daharoni/Miniscope_DAQ_PCB/v3_2/Assembly Files/USB_Control_FPD_Linkv2_BOM.xlsx

Value | Comment | Digikey Part Number | Manufacturer Part Number | Designator | Footprint | LibRef | Quantity
CAPACITORS
N/A | Open Capacitor | N/A | N/A | C73 | 0603 |  | 1 | 178
0.01uF | CAP CER 10000PF 50V 10% X7R 0603 | 490-1512-1-ND (http://www.digikey.com/product-detail/en/GRM188R71H103KA01D/490-1512-1-ND/587862) | GRM188R71H103KA01D (http://www.digikey.com/product-detail/en/GRM188R71H103KA01D/490-1512-1-ND/587862) | C6, C8, C11, C14, C16, C19, C25, C28, C29, C31, C38, C43, C44, C47, C49, C51, C60, C62, C64, C66, C82 | 0603 |  | 21
0.047uF | CAP CER 0.047UF 25V 10% X7R 0402 | 490-3254-1-ND (http://www.digikey.com/product-detail/en/GRM155R71E473KA88D/490-3254-1-ND/702795) | GRM155R71E473KA88D (http://www.digikey.com/product-detail/en/GRM155R71E473KA88D/490-3254-1-ND/702795) | C22, C27 | 0402 |  | 2
0.1uF | CAP CER 0.1UF 16V 10% X7R 0402 | 490-3261-1-ND (http://www.digikey.com/product-detail/en/GRM155R71C104KA88D/490-3261-1-ND/702802) | GRM155R71C104KA88D (http://www.digikey.com/product-detail/en/GRM155R71C104KA88D/490-3261-2-ND/675947) | C21, C26, C77 | 0402 |  | 3
0.1uF | CAP CER 0.1UF 16V 10% X7R 0603 | 490-1532-1-ND (http://www.digikey.com/product-detail/en/GRM188R71C104KA01D/490-1532-1-ND/587771) | GRM188R71C104KA01D (http://www.digikey.com/product-detail/en/GRM188R71C104KA01D/490-1532-1-ND/587771) | C1, C2, C3, C7, C9, C12, C15, C17, C20, C24, C32, C37, C40, C41, C42, C45, C46, C48, C50, C52, C54, C56, C58, C59, C61, C63, C65, C69, C78, C79 | 0603 |  | 30
1uF | CAP CER 1UF 10V 10% X5R 0603 | 490-1543-1-ND (http://www.digikey.com/product-detail/en/GRM188R61A105KA61D/490-1543-1-ND/587782) | GRM188R61A105KA61D (http://www.digikey.com/product-detail/en/GRM188R61A105KA61D/490-1543-1-ND/587782) | C4, C5, C70 | 0603 |  | 3
2.2uF | CAP CER 2.2UF 16V 10% X5R 0603 | 490-3296-1-ND (http://www.digikey.com/product-detail/en/GRM188R61C225KE15D/490-3296-1-ND/702837) | GRM188R61C225KE15D (http://www.digikey.com/product-detail/en/GRM188R61C225KE15D/490-3296-1-ND/702837) | C53, C74 | 0603 |  | 2
4.7uF | CAP CER 4.7UF 16V 10% X5R 0603 | 490-10730-1-ND (http://www.digikey.com/product-detail/en/GRM188R61C475KE11D/490-10730-1-ND/5251370) | GRM188R61C475KE11D (http://www.digikey.com/product-detail/en/GRM188R61C475KE11D/490-10730-1-ND/5251370) | C10, C23, C67, C68, C75, C76 | 0603 |  | 6
10uF | CAP CER 10UF 16V 20% X5R 0603 | 490-7201-1-ND (http://www.digikey.com/product-detail/en/GRM188R61C106MA73D/490-7201-1-ND/3900482) | GRM188R61C106MA73D (http://www.digikey.com/product-detail/en/GRM188R61C106MA73D/490-7201-1-ND/3900482) | C30, C71, C72 | 0603 |  | 3
22uF | CAP CER 22UF 6.3V 20% X5R 0603 | 490-7611-1-ND (http://www.digikey.com/product-detail/en/GRM188R60J226MEA0D/490-7611-1-ND/4280544) | GRM188R60J226MEA0D (http://www.digikey.com/product-detail/en/GRM188R60J226MEA0D/490-7611-1-ND/4280544) | C13, C18, C39, C55, C57 | 0603 |  | 5
100uF | CAP TANT 100UF 6.3V 20% 1206 | 511-1498-1-ND (http://www.digikey.com/product-detail/en/TCTAL0J107M8R/511-1498-1-ND/1209675) | TCTAL0J107M8R (http://www.digikey.com/product-detail/en/TCTAL0J107M8R/511-1498-1-ND/1209675) | C33, C34 | 1206 |  | 2
330uF | CAP TANT 330UF 10V 10% 2917 | 399-3884-1-ND (http://www.digikey.com/product-detail/en/T495D337K010ATE125/399-3884-1-ND/819209) | T495D337K010ATE125 (http://www.digikey.com/product-detail/en/T495D337K010ATE125/399-3884-1-ND/819209) | C35, C36 | 2917 |  | 2
RESISTORS
N/A | Open Resistor | N/A | N/A | R27, R30, R32 | 0603 |  | 3
0 | RES SMD 0.0 OHM JUMPER 1/10W | 311-0.0HRCT-ND (http://www.digikey.com/product-detail/en/RC0603FR-070RL/311-0.0HRCT-ND/4340584) | RC0603FR-070RL (http://www.digikey.com/product-detail/en/RC0603FR-070RL/311-0.0HRCT-ND/4340584) | R44, R45 | 0603 |  | 2
22 | RES SMD 22 OHM 1% 1/10W 0603 | 311-22.0HRCT-ND (http://www.digikey.com/product-detail/en/RC0603FR-0722RL/311-22.0HRCT-ND/730002) | RC0603FR-0722RL (http://www.digikey.com/product-detail/en/RC0603FR-0722RL/311-22.0HRCT-ND/730002) | R6, R7, R8, R9. R10. R11, R13, R15, R16, R17, R18, R19, R20, R21, R22, R23, R24, R25, R29 | 0603 |  | 19
33 | RES SMD 33 OHM 1% 1/10W 0603 | 311-33.0HRCT-ND (http://www.digikey.com/product-detail/en/RC0603FR-0733RL/311-33.0HRCT-ND/730105) | RC0603FR-0733RL (http://www.digikey.com/product-detail/en/RC0603FR-0733RL/311-33.0HRCT-ND/730105) | R59 | 0603 |  | 1
49.9 | RES SMD 49.9 OHM 1% 1/16W 0402 | 311-49.9LRCT-ND (http://www.digikey.com/product-detail/en/RC0402FR-0749R9L/311-49.9LRCT-ND/729568) | RC0402FR-0749R9L (http://www.digikey.com/product-detail/en/RC0402FR-0749R9L/311-49.9LRCT-ND/729568) | R34, R35 | 0402 |  | 2
100 | RES SMD 100 OHM 1% 1/10W 0603 | 311-100HRCT-ND (http://www.digikey.com/product-detail/en/RC0603FR-07100RL/311-100HRCT-ND/729835) | RC0603FR-07100RL (http://www.digikey.com/product-detail/en/RC0603FR-07100RL/311-100HRCT-ND/729835) | R64, R65, R66 | 0603 |  | 3
200 | RES SMD 200 OHM 1% 1/10W 0603 | 311-200HRCT-ND (http://www.digikey.com/product-detail/en/RC0603FR-07200RL/311-200HRCT-ND/729990) | RC0603FR-07200RL (http://www.digikey.com/product-detail/en/RC0603FR-07200RL/311-200HRCT-ND/729990) | R5 | 0603 |  | 1
430 | RES SMD 430 OHM 1% 1/10W 0603 | 311-430HRCT-ND (http://www.digikey.com/product-detail/en/RC0603FR-07430RL/311-430HRCT-ND/730183) | RC0603FR-07430RL (http://www.digikey.com/product-detail/en/RC0603FR-07430RL/311-430HRCT-ND/730183) | R52 | 0603 |  | 1
1k | RES SMD 1K OHM 1% 1/10W 0603 | 311-1.00KHRCT-ND (http://www.digikey.com/product-detail/en/RC0603FR-071KL/311-1.00KHRCT-ND/729790) | RC0603FR-071KL (http://www.digikey.com/product-detail/en/RC0603FR-071KL/311-1.00KHRCT-ND/729790) | R50, R60, R61, R63, R56, R57 | 0603 |  | 6
1.15k | RES SMD 1.15K OHM 1% 1/10W 0603 | 311-1.15KHRCT-ND (http://www.digikey.com/product-detail/en/RC0603FR-071K15L/311-1.15KHRCT-ND/729797) | RC0603FR-071K15L (http://www.digikey.com/product-detail/en/RC0603FR-071K15L/311-1.15KHRCT-ND/729797) | R55 | 0603 |  | 1
2k | RES SMD 2K OHM 1% 1/10W 0603 | 311-2.00KHRCT-ND (http://www.digikey.com/product-detail/en/RC0603FR-072KL/311-2.00KHRCT-ND/729956) | RC0603FR-072KL (http://www.digikey.com/product-detail/en/RC0603FR-072KL/311-2.00KHRCT-ND/729956) | R12, R14 | 0603 |  | 2
3.57k | RES SMD 3.57K OHM 1% 1/10W 0603 | 311-3.57KHRCT-ND (http://www.digikey.com/product-detail/en/RC0603FR-073K57L/311-3.57KHRCT-ND/730078) | RC0603FR-073K57L (http://www.digikey.com/product-detail/en/RC0603FR-073K57L/311-3.57KHRCT-ND/730078) | R53 | 0603 |  | 1
6.04k | RES SMD 6.04K OHM 1% 1/10W 0603 | 311-6.04KHRCT-ND (http://www.digikey.com/product-detail/en/RC0603FR-076K04L/311-6.04KHRCT-ND/730264) | RC0603FR-076K04L (http://www.digikey.com/product-detail/en/RC0603FR-076K04L/311-6.04KHRCT-ND/730264) | R4 | 0603 |  | 1
10k | RES SMD 10K OHM 1% 1/10W 0603 | 311-10.0KHRCT-ND (http://www.digikey.com/product-detail/en/RC0603FR-0710KL/311-10.0KHRCT-ND/729827) | RC0603FR-0710KL (http://www.digikey.com/product-detail/en/RC0603FR-0710KL/311-10.0KHRCT-ND/729827) | R1, R2, R3, R26, R28, R31, R36, R37, R38, R39, R40, R41, R42, R43, R47, R48, R49, R51 | 0603 |  | 18
11K | RES SMD 11K OHM 1% 1/10W 0603 | 311-11.0KHRCT-ND (http://www.digikey.com/product-detail/en/RC0603FR-0711KL/311-11.0KHRCT-ND/729844) | RC0603FR-0711KL (http://www.digikey.com/product-detail/en/RC0603FR-0711KL/311-11.0KHRCT-ND/729844) | R46 | 0603 |  | 1
30.1k | RES SMD 30.1K OHM 1% 1/10W 0603 | 311-30.1KHRCT-ND (http://www.digikey.com/product-detail/en/RC0603FR-0730K1L/311-30.1KHRCT-ND/730089) | RC0603FR-0730K1L (http://www.digikey.com/product-detail/en/RC0603FR-0730K1L/311-30.1KHRCT-ND/730089) | R54 | 0603 |  | 1
100k | RES SMD 100K OHM 1% 1/10W 0603 | 311-100KHRCT-ND (http://www.digikey.com/product-detail/en/RC0603FR-07100KL/311-100KHRCT-ND/729836) | RC0603FR-07100KL (http://www.digikey.com/product-detail/en/RC0603FR-07100KL/311-100KHRCT-ND/729836) | R58 | 0603 |  | 1
1M | RES SMD 1M OHM 1% 1/10W 0603 | 311-1.00MHRCT-ND (http://www.digikey.com/product-detail/en/RC0603FR-071ML/311-1.00MHRCT-ND/729791) | RC0603FR-071ML (http://www.digikey.com/product-detail/en/RC0603FR-071ML/311-1.00MHRCT-ND/729791) | R33 | 0603 |  | 1
Ferrite
Ferrite | FERRITE CHIP 220 OHM 0805 | 490-1054-1-ND (http://www.digikey.com/product-detail/en/BLM21PG221SN1D/490-1054-1-ND/574418) | BLM21PG221SN1D (http://www.digikey.com/product-detail/en/BLM21PG221SN1D/490-1054-1-ND/574418) | L1, L2 | 0805 |  | 2
Ferrite | FERRITE CHIP 600 OHM 1300MA 0603 | 490-5258-1-ND (http://www.digikey.com/product-detail/en/BLM18KG601SN1D/490-5258-1-ND/1982781) | BLM18KG601SN1D (http://www.digikey.com/product-detail/en/BLM18KG601SN1D/490-5258-1-ND/1982781) | L3, L4, L11 | 0603 |  | 3
Ferrite | FIXED IND 2.2UH 600MA 340 MOHM | 490-4994-1-ND (http://www.digikey.com/product-detail/en/LQM21PN2R2MC0D/490-4994-1-ND/1788292) | LQM21PN2R2MC0D (http://www.digikey.com/product-detail/en/LQM21PN2R2MC0D/490-4994-1-ND/1788292) | L5 | 0805 |  | 1
Ferrite | FERRITE CHIP BEAD 600 OHM SMD | 445-2206-1-ND (http://www.digikey.com/product-detail/en/MPZ2012S601AT000/445-2206-1-ND/765104) | MPZ2012S601AT000 (http://www.digikey.com/product-detail/en/MPZ2012S601AT000/445-2206-1-ND/765104) | L6, L7, L8, L9, L10 | 0805 |  | 5
Ferrite | FIXED IND 4.7UH 750MA 260 MOHM | 1276-6204-1-ND (http://www.digikey.com/product-detail/en/CIG21L4R7MNE/1276-6204-1-ND/3972122) | CIG21L4R7MNE (http://www.digikey.com/product-detail/en/CIG21L4R7MNE/1276-6204-1-ND/3972122) | L12 | 0805 |  | 1
Ferrite | FIXED IND 100UH 340MA 1.82 OHM | 587-1628-1-ND (http://www.digikey.com/product-detail/en/CBC3225T101MR/587-1628-1-ND/1008243) | CBC3225T101MR (http://www.digikey.com/product-detail/en/CBC3225T101MR/587-1628-1-ND/1008243) | L13 | 1210 |  | 1
CLOCKS
FXO_HC53 | OSC XO 26.000MHZ HCMOS SMD | 631-1320-1-ND (http://www.digikey.com/product-detail/en/FXO-HC536R-26/631-1320-1-ND/2155361) | FXO-HC536R-26 (http://www.digikey.com/product-detail/en/FXO-HC536R-26/631-1320-1-ND/2155361) | *1 |  |  | 1
SG-3040LC | OSC XO 32.768KHZ CMOS SMD | SER3697CT-ND (http://www.digikey.com/product-detail/en/SG-3040LC%2032.7680KB3:%20PURE%20SN/SER3697CT-ND/2403470) | SG-3040LC 32.7680KB3: PURE SN (http://www.digikey.com/product-detail/en/SG-3040LC%2032.7680KB3:%20PURE%20SN/SER3697CT-ND/2403470) | u10 |  |  | 1
IC
ESD_4Channel | TVS DIODE 6VWM 12.3VC UDFN | F3507CT-ND (http://www.digikey.com/product-detail/en/SP3010-04UTG/F3507CT-ND/2297266) | SP3010-04UTG (http://www.digikey.com/product-detail/en/SP3010-04UTG/F3507CT-ND/2297266) | U1 | UDFN |  | 1
FX3 USB Controller | IC ARM9 USB3 CONTROLLER 121FBGA | 428-3181-ND (http://www.digikey.com/product-detail/en/CYUSB3013-BZXC/428-3181-ND/3679588) | CYUSB3013-BZXC (http://www.digikey.com/product-detail/en/CYUSB3013-BZXC/428-3181-ND/3679588) | U2 | 121FBGA |  | 1
USB Over B Prot. | IC USB POS OVP/OCP 5TSOP | NCP361SNT1GOSCT-ND (http://www.digikey.com/product-detail/en/NCP361SNT1G/NCP361SNT1GOSCT-ND/1894072) | NCP361SNT1G (http://www.digikey.com/product-detail/en/NCP361SNT1G/NCP361SNT1GOSCT-ND/1894072) | U3 | 5TSOP |  | 1
Deserializer | IC SER/DES 25-100MHZ FPD 48WQFN | 296-38936-1-ND (http://www.digikey.com/product-detail/en/DS90UB914ATRHSTQ1/296-38936-1-ND/5143035) | DS90UB914ATRHSTQ1 (http://www.digikey.com/product-detail/en/DS90UB914ATRHSTQ1/296-38936-1-ND/5143035) | U4 | 48WQFN |  | 1
Power 3.3V | IC REG LDO ADJ 1.5A 10SON | 296-21563-1-ND (http://www.digikey.com/product-detail/en/TPS74801DRCR/296-21563-1-ND/1426949) | TPS74801DRCR (http://www.digikey.com/product-detail/en/TPS74801DRCR/296-21563-1-ND/1426949) | U6 | 10SON |  | 1
Power 1.2V | IC REG LDO ADJ 1A 8SOIC | 296-39494-1-ND (http://www.digikey.com/product-detail/en/TPS76801QDR/296-39494-1-ND/5143442) | TPS76801QDR (http://www.digikey.com/product-detail/en/TPS76801QDR/296-39494-1-ND/5143442) | U7 | 8SOIC |  | 1
Power 1.8V | IC REG BUCK 1.8V 0.5A SYNC 6SON | 296-24485-1-ND (http://www.digikey.com/product-detail/en/TPS62231DRYT/296-24485-1-ND/2057751) | TPS62231DRYT (http://www.digikey.com/product-detail/en/TPS62231DRYT/296-24485-1-ND/2057751) | U8 | 6SON |  | 1
NPN Trans | TRANS NPN 40V 0.2A SOT23 | MMBT3904TPMSCT-ND (http://www.digikey.com/product-detail/en/MMBT3904-TP/MMBT3904TPMSCT-ND/717395) | MMBT3904-TP (http://www.digikey.com/product-detail/en/MMBT3904-TP/MMBT3904TPMSCT-ND/717395) | U15, U16, U18 | SOT23 |  | 3
Connectors
USB3 MicoB | CONN MICRO USB B 3.0 HORIZ SMT | ED1128CT-ND (http://www.digikey.com/product-detail/en/897-10-010-40-300002/ED1128CT-ND/3821395) | 897-10-010-40-300002 (http://www.digikey.com/product-detail/en/897-10-010-40-300002/ED1128CT-ND/3821395) | J1 |  |  | 1
DC Jack | CONN PWR JACK 2.5X6.3MM SMT | CP-036BHPJCT-ND (http://www.digikey.com/product-detail/en/PJ-036BH-SMT-TR/CP-036BHPJCT-ND/1530996) | PJ-036BH-SMT-TR (http://www.digikey.com/product-detail/en/PJ-036BH-SMT-TR/CP-036BHPJCT-ND/1530996) | J2 |  |  | 1
Other
Switch 4 lines | SWITCH DIP HALF PITCH 4POS 50V | CT2184LPST-ND (http://www.digikey.com/product-detail/en/218-4LPST/CT2184LPST-ND/267320) | 218-4LPST (http://www.digikey.com/product-detail/en/218-4LPST/CT2184LPST-ND/267320) | SW1, SW2, SW3 |  |  | 3
LED | LED GREEN CLEAR THIN 0603 SMD | 160-1446-1-ND (http://www.digikey.com/product-detail/en/LTST-C191KGKT/160-1446-1-ND/386834) | LTST-C191KGKT (http://www.digikey.com/product-detail/en/LTST-C191KGKT/160-1446-1-ND/386834) | U11, U12, U14 | 0603 |  | 3
Through-hole Parts
Right Angle SMA Jack | CONN SMA JACK R/A 50 OHM PCB | CONSMA002-ND | CONSMA002 | J3, J4, J5 | Through Hole SMA |  | 3
8POS Socket | CONN IC DIP SOCKET 8POS TIN | 609-4717-ND | DILB8P-223TLF | U5 | 2x4 socket, 0.1" pitch |  | 1
3x2 Header | CONN HEADER 6POS .100 STR 15AU | 609-3210-ND | 67996-206HLF | K1/K2/K3 | 2x3 header, 0.1" pitch |  | 1
3x1 Header | CONN HEADR BRKWAY .100 3POS STR | 5-146280-3-ND | 5-146280-3 | J9 | 1x3 header, 0.1" pitch |  | 1
