daharoni/Miniscope_DAQ_PCB/v3_2/Fabrication Files/Optional Positive Power Plane Gerbers/ReadMe.docx

This folder contains the positive gerber versions (G1 and G2) of the negative power plane gerbers (GP1 and GP2). It is important to note that we have not yet used these positive gerbers to fabrication the DAQ PCB. Use at your own risk.

- USB_Control.G1 is the positive gerber of USB_Control.GP1
- USB_Control.G2 is the positive gerber of USB_Control.GP2
- Order of copper layers:
  - Component layer (Top Layer)
  - Ground plane (GP1 or G1)
  - Power plane (GP2 or G2)
  - Signal layer (Bottom Layer)
