daharoni/Miniscope_DAQ_PCB/v2_01/Assembly Files_Only SMD/Miniscope_DAQ_PCB_Assy_Info.docx

Miniscope DAQ PCB Assembly Information

Assembly:

- 1 BGA (.8mm pitch)
- Unique components: 49
- Smallest footprint: 0402
- Total parts: 179
- All surface mounts
- All on top layer
- U11, U12, U14 LED orientation is shown below:

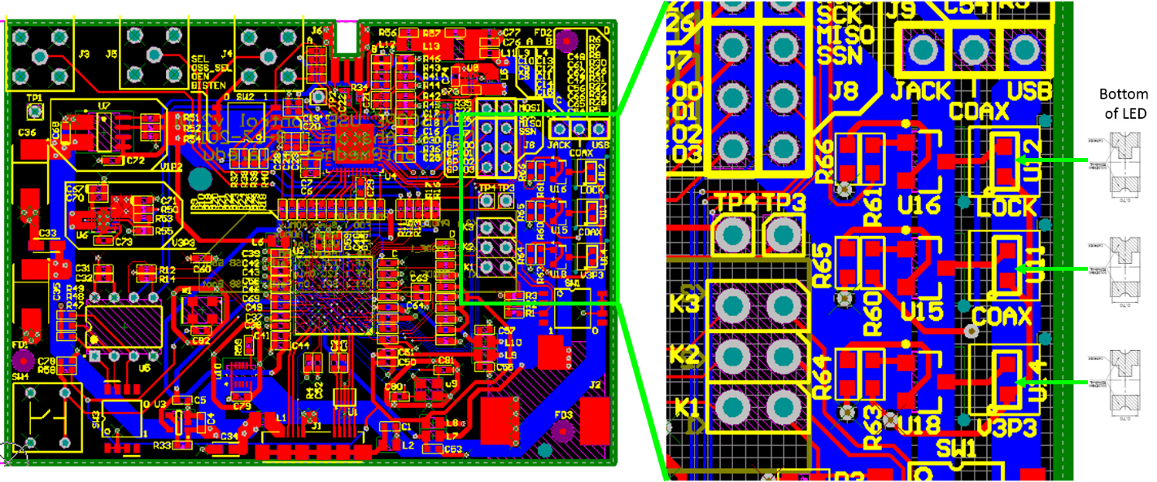
[picture p12: figure]

Top of LED
