daharoni/Miniscope_DAQ_PCB/(threads)

Thread 1 (2016-10-28):

Positive Gerbers in Fabrication Files

jonnew, 2016-10-28:
A lot of cheap PCB sources (e.g. OSH Park) only accept positive gerbers.

http://docs.oshpark.com/submitting-orders/inverted-gerbers/

Currently, it seems that inner planes are provided as negative gerbers. It would be great to have two folders, one for positive gerbers and one for negative.

daharoni, 2016-10-28:
Hi Jon,
I am generating positive planes right now. Should have it updated in a few minutes. By the way, we also have a newer version of the DAQ PCB that I will update as well.

daharoni, 2016-10-28:
Alright, everything has been updated with additional positive power plane gerbers. Please use v3.2 when making DAQ PCBs now.

jonnew, 2016-10-28:
:+1: Thank you!

jonnew, 2016-10-28:
Out of curiosity, how did you generate them? I use EAGLE so I have no idea how to do it in Altium.

daharoni, 2016-10-28:
I added two internal layers to the PCB (not power planes) and then place polygon pours on each layer with the appropriate nets. The Layer Stack Manager in Altium is where you can add or change layers.

I use to use EAGLE when I mainly worked on simple 2 layered boards but, in my opinion, EAGLE becomes really difficult to deal with when working on 4+ layer PCBs or more complex layouts. I now have switched over to using the free version of Altium called CircuitMaker. It has almost all the features of Altium but requires all but two of your project to be public and shared on their cloud. For open source projects CircuitMaker is actually really nice since it support version control, easy sharing, and collaboration. At some point I will port over the CMOS PCB and DAQ PCB over to CircuitMaker but I haven't gotten around to it yet.

jonnew, 2016-10-28:
Cool! Yeah, I regularly make fairly complex 4-layer PCBs in EAGLE and it
just an energetic barrier preventing me from switching. I will def look
into CircuitMaker, thanks for the info about that :)

On Fri, Oct 28, 2016 at 3:57 PM, Daniel Aharoni <notifications@github.com>
wrote:

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

--
Jonathan Newman
Postdoctoral Fellow, MIT
http://www.mit.edu/~jpnewman/

Closed 2016-10-28.

Thread 2 (2016-10-28):

DRU files

jonnew, 2016-10-28:
It would be great if the project included the design rule file used to check for electrical errors in the PCB layout. This way we can make sure any modifications to the files are within the standard spec. The reason I'm suggesting this is because we are attempting to handle #1 by re-creating the power and ground planes as polygon pours, but we want to make sure these pours are not violating the design rules for the PCB. Once we have them we can send a PR that should close #1.

jonnew, 2016-10-28:
It seems like the DRU might be embedded in the project file, but we aren't sure. In any case, having a clean external DRU would be very good.

daharoni, 2016-10-28:
I'm not sure how to generate an external DRU but I will look into it.
