daharoni/Miniscope_DAQ_PCB/v3_2/Miniscope_USB_Controlv3_2.PDF

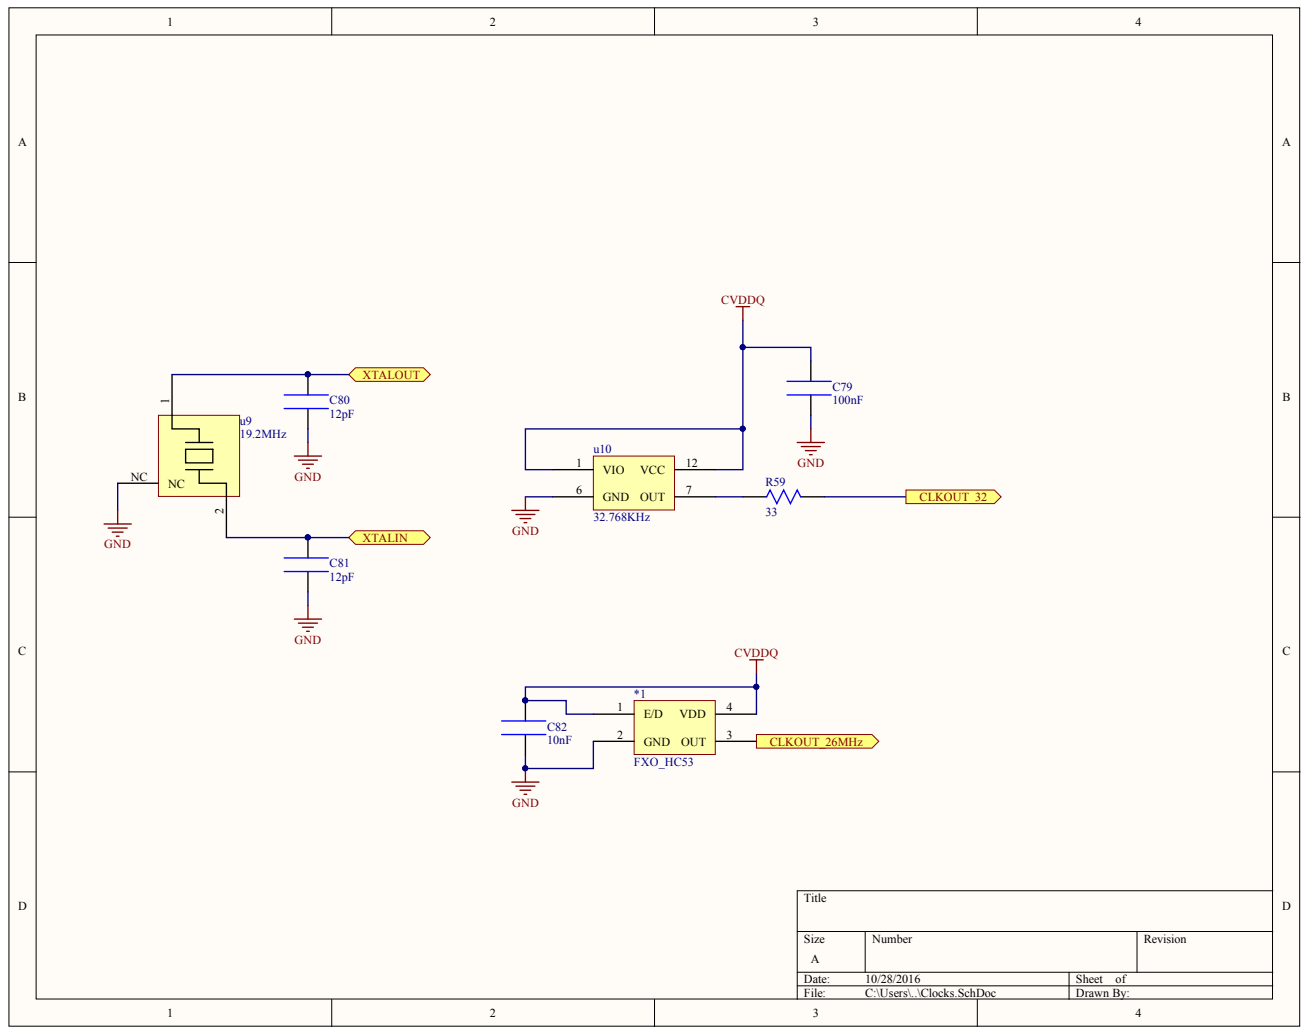
[picture p13: page 1]

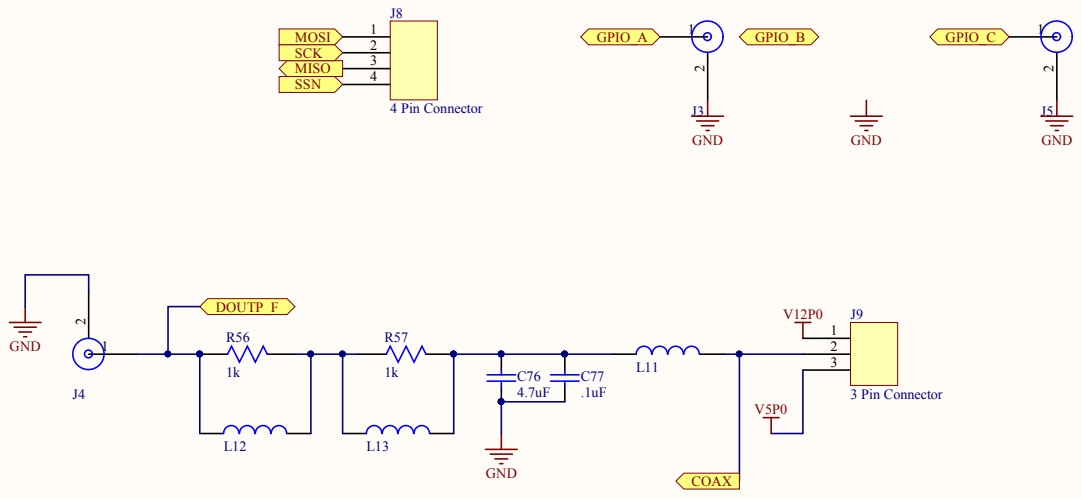
[picture p14: page 2]

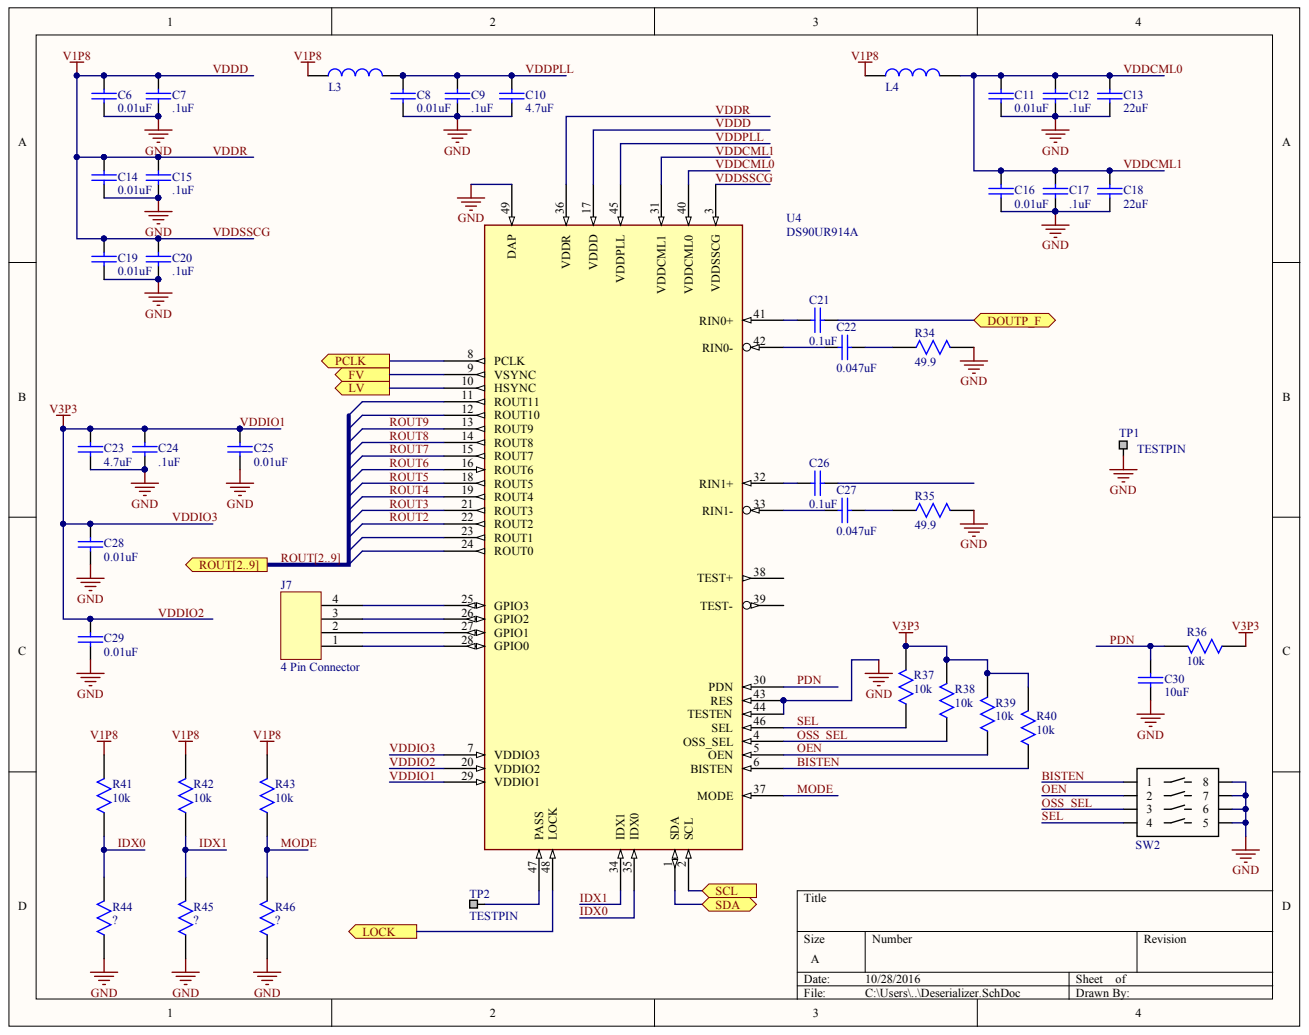
[picture p15: page 3]

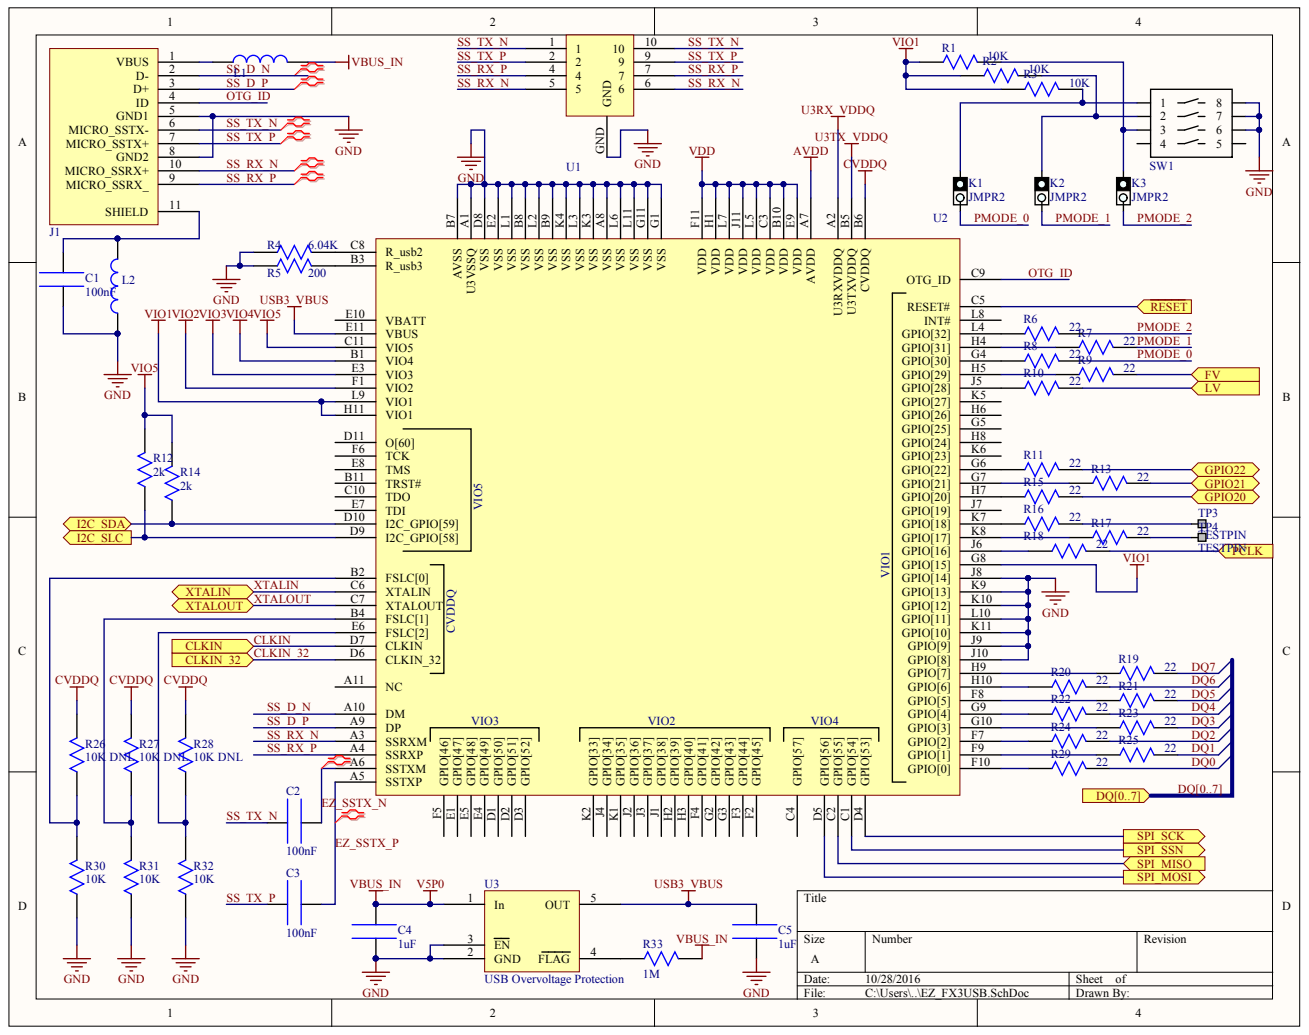
[picture p16: page 4]

VSS A8 VSS K3 VSS L3 VSS K4

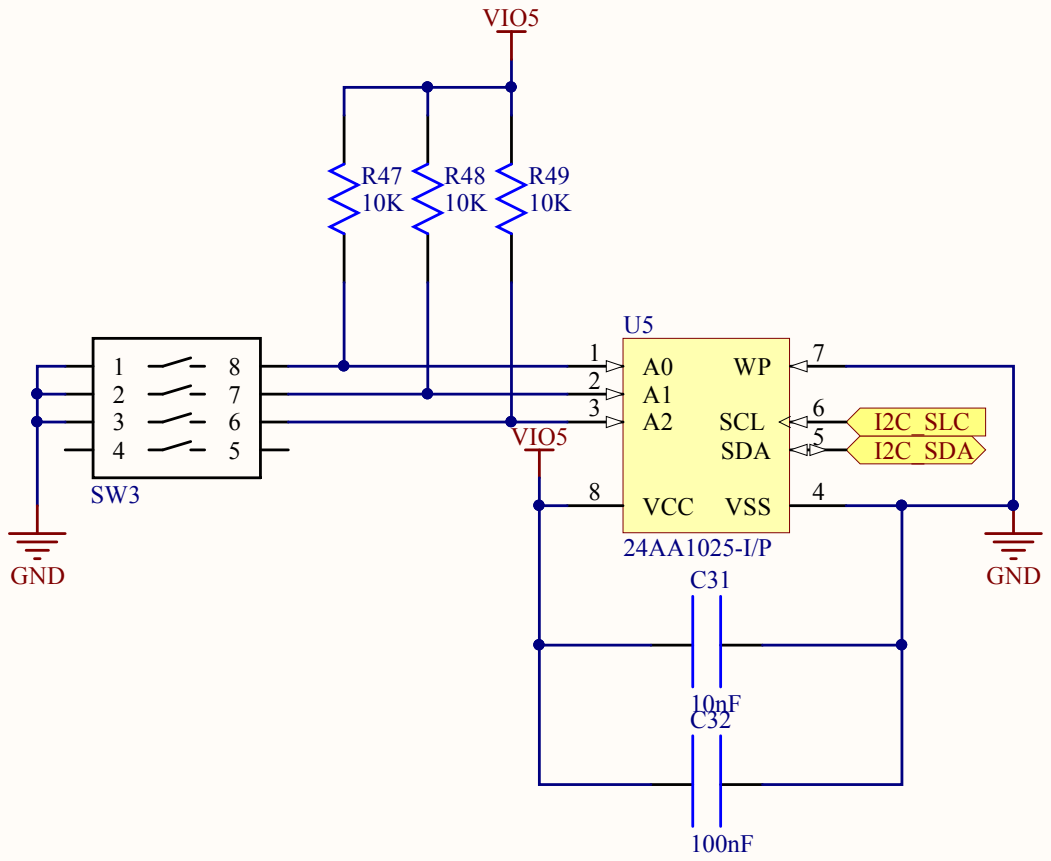
[picture p17: page 5]

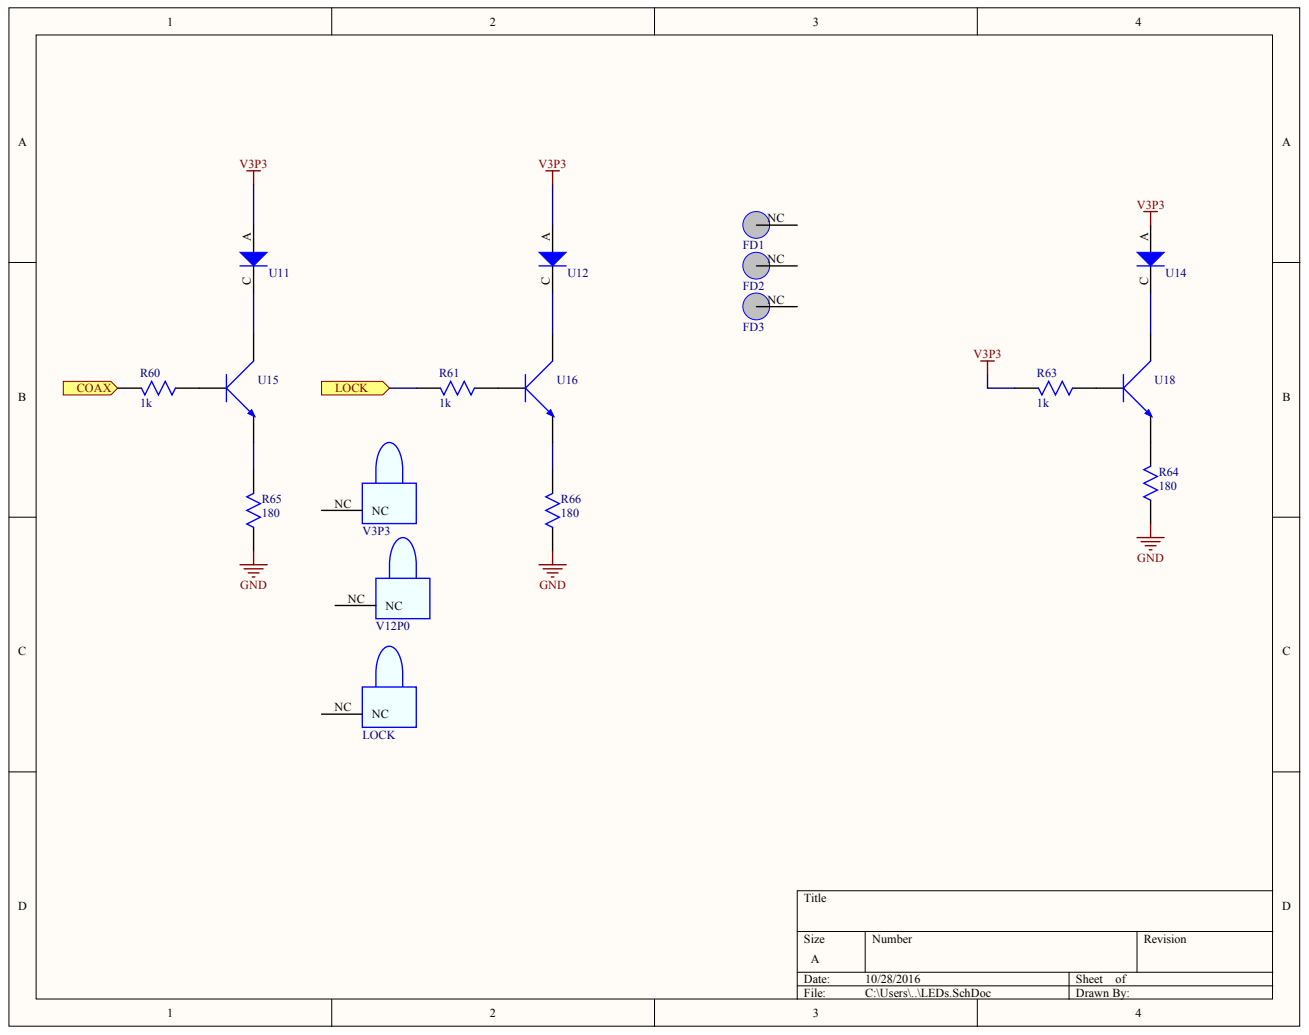
[picture p18: page 6]

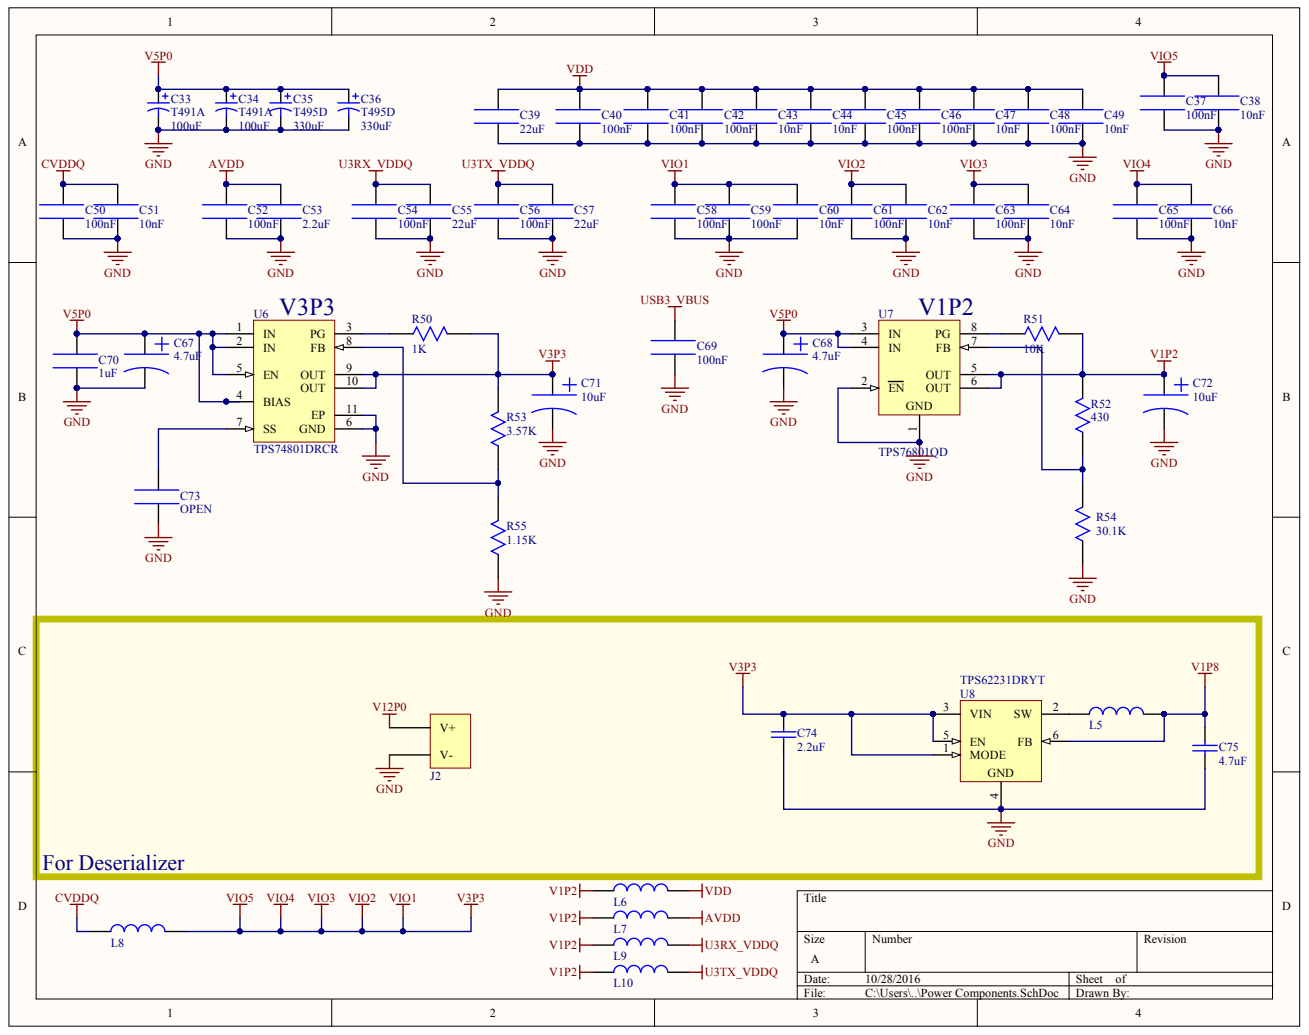
[picture p19: page 7]

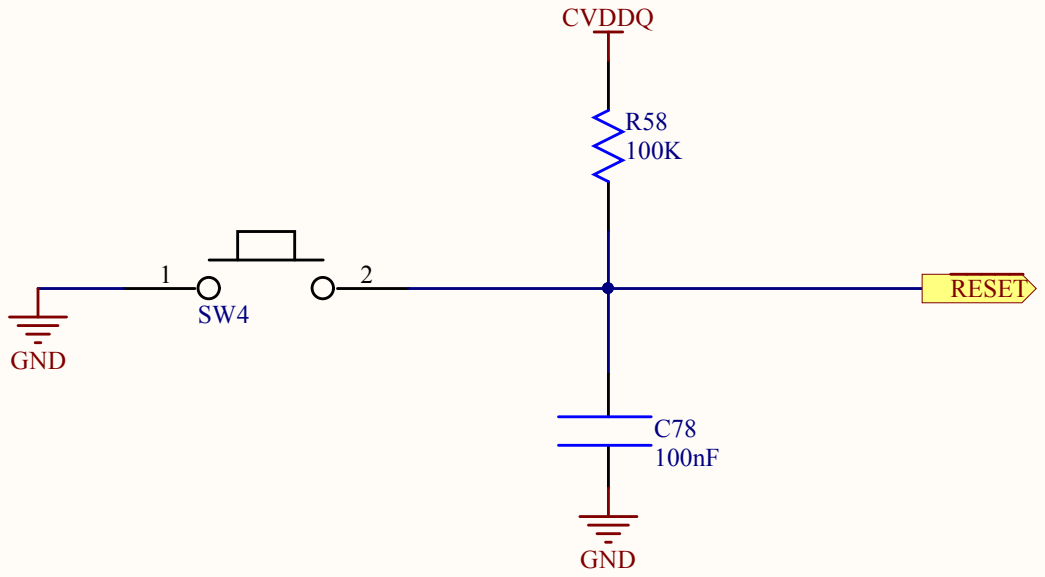
[picture p20: page 8]

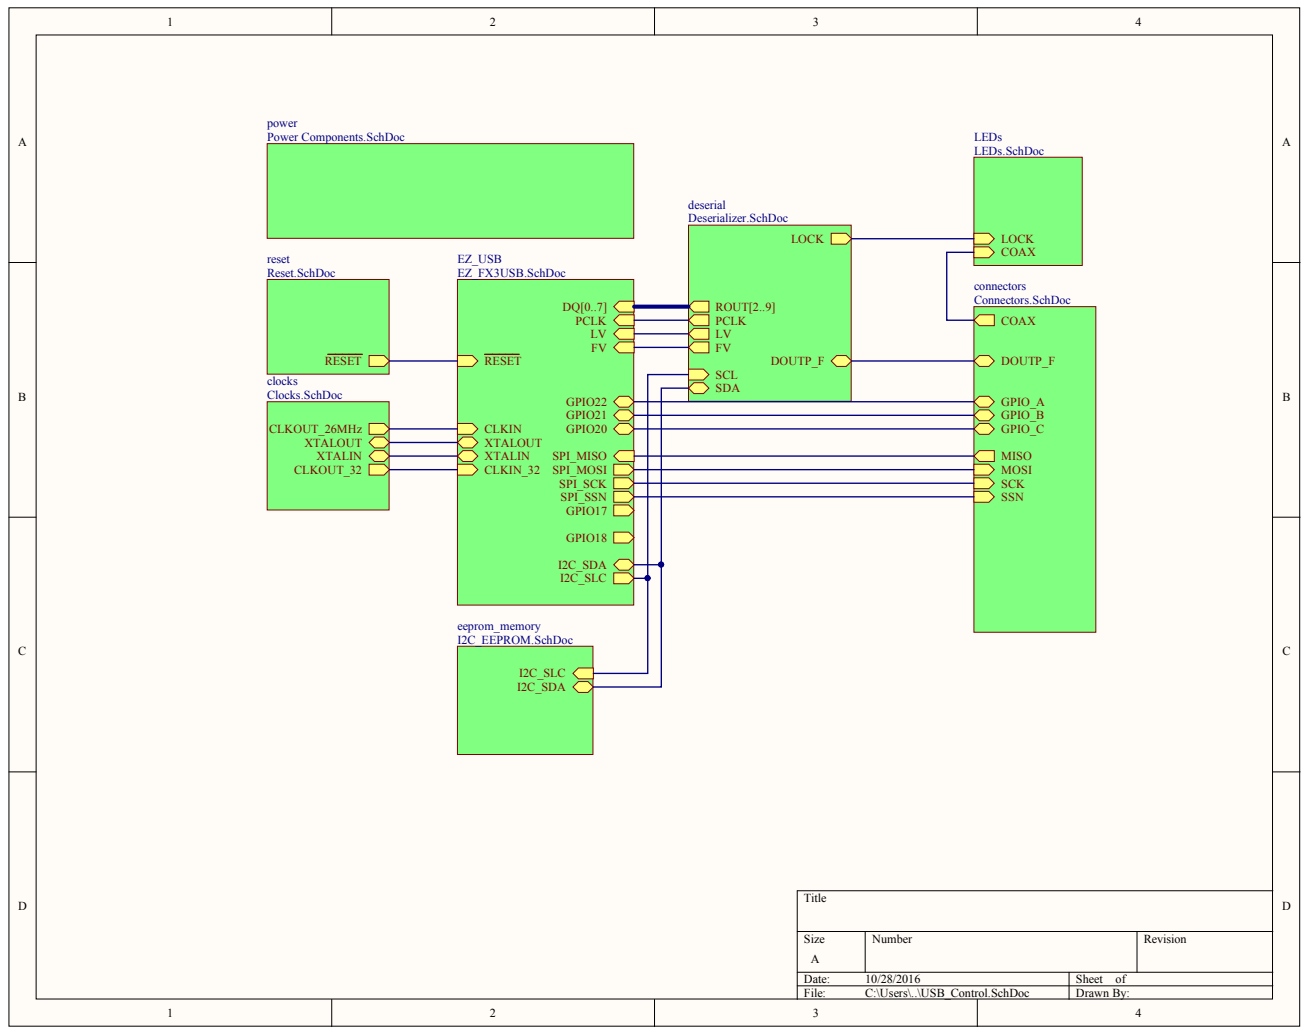
[picture p21: page 9]

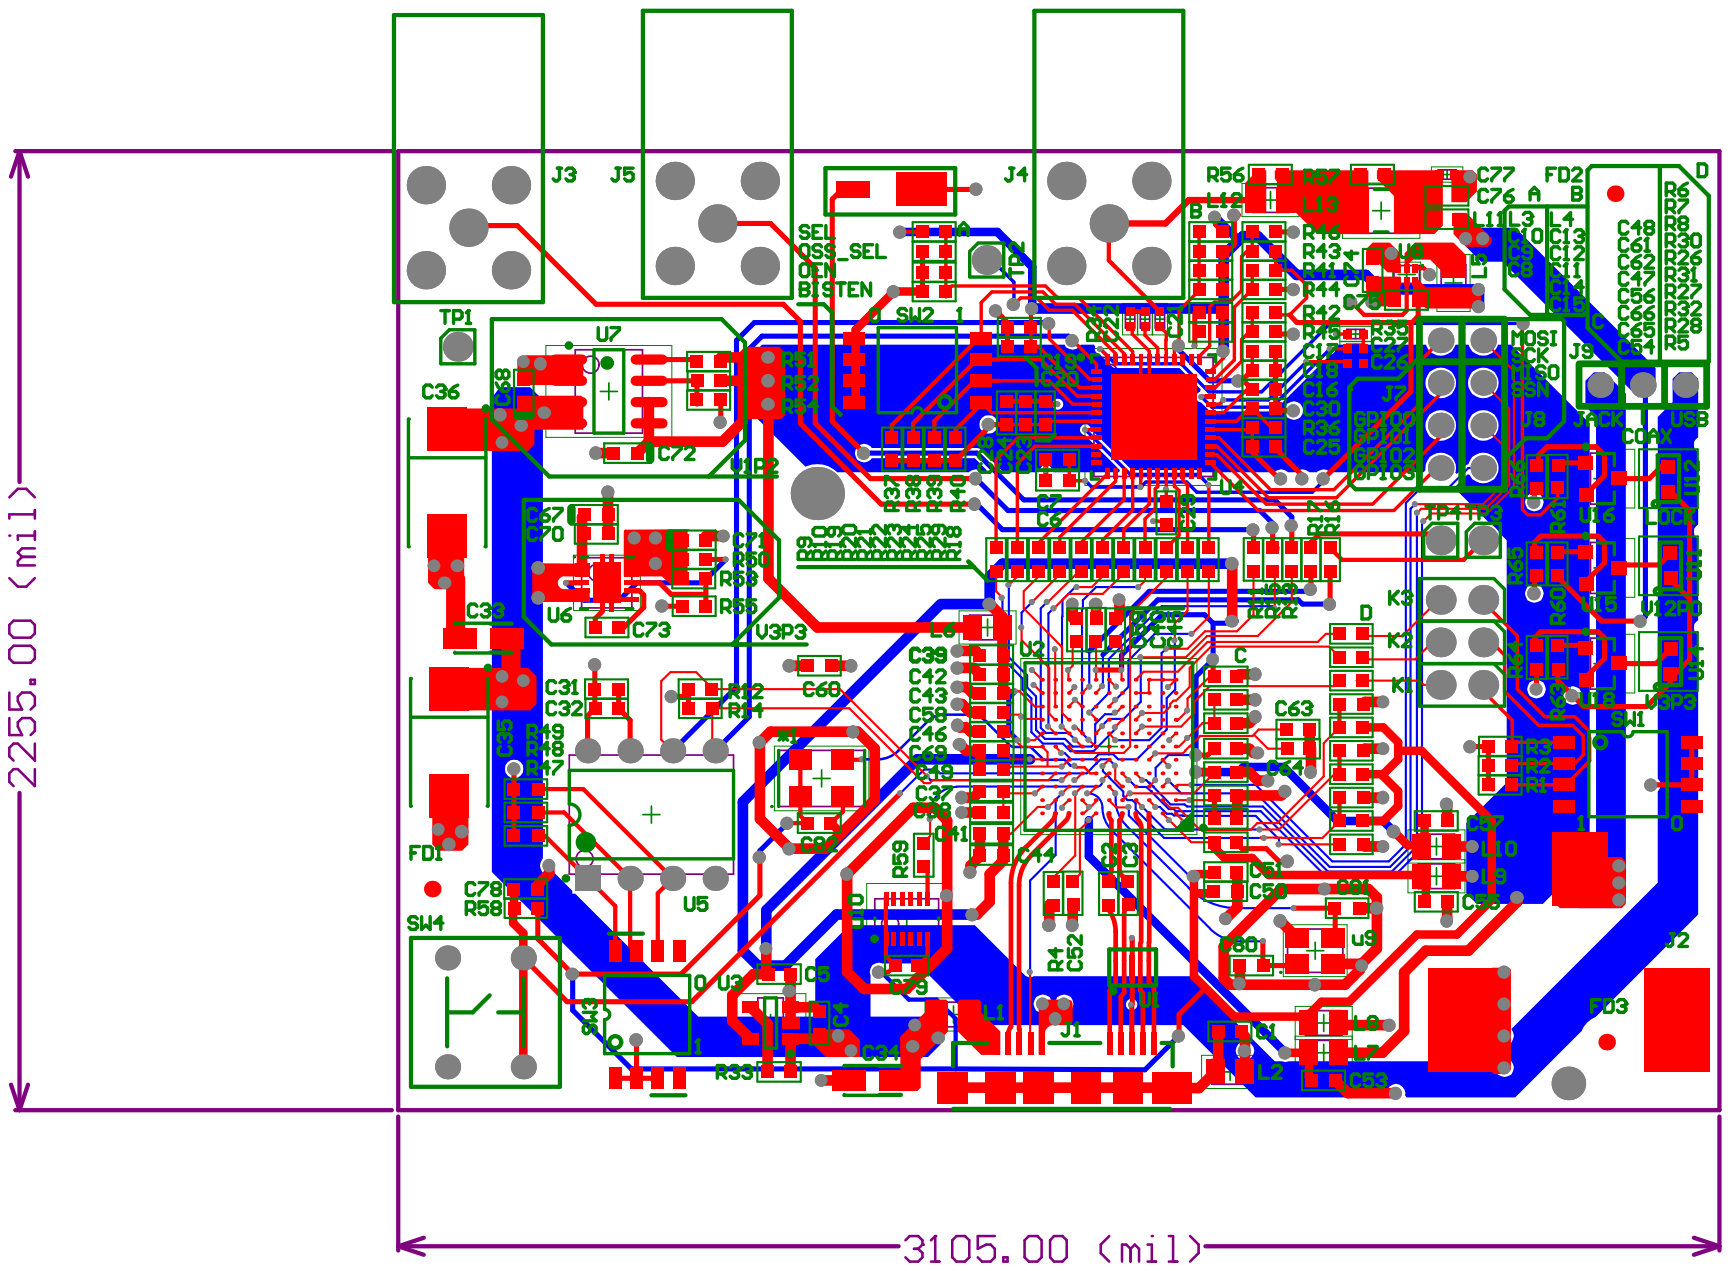
[picture p22: page 10]
