daharoni/Miniscope_DAQ_PCB/v2_01/Miniscope_DAQ_PCB_Schematics_Layout.PDF

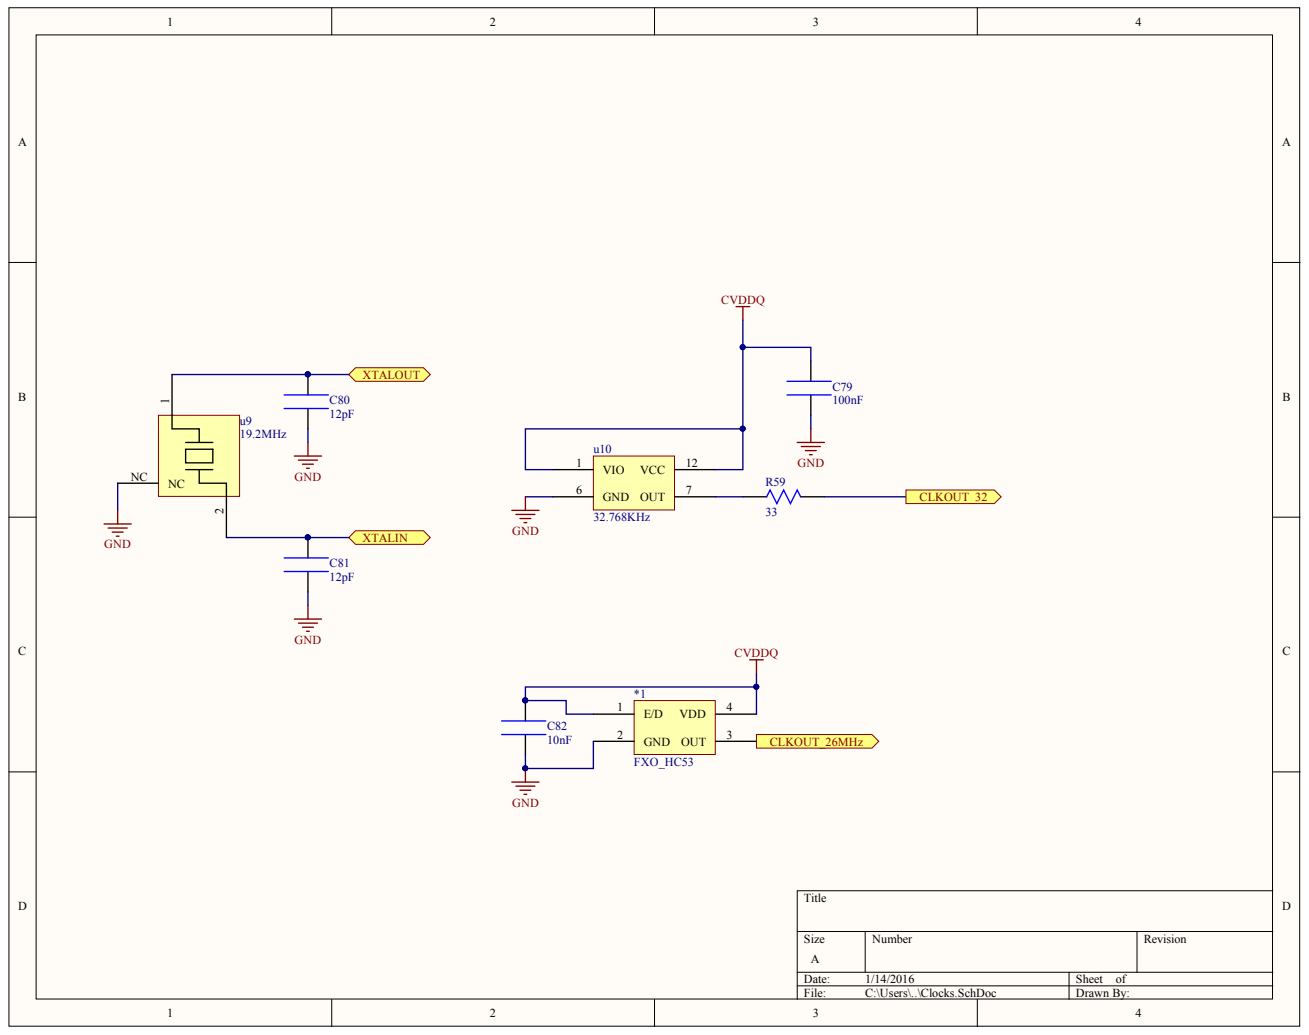
[picture p23: page 1]

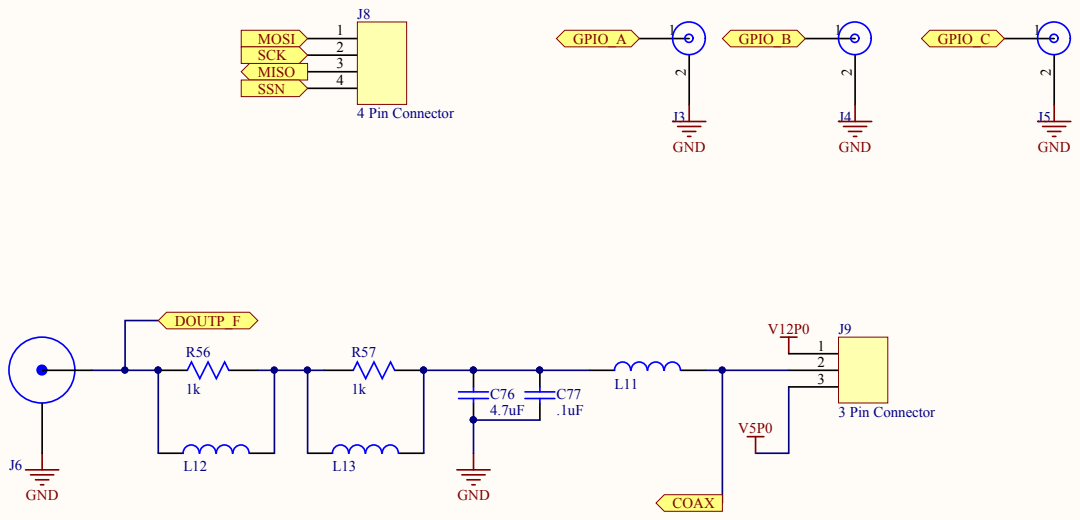
[picture p24: page 2]

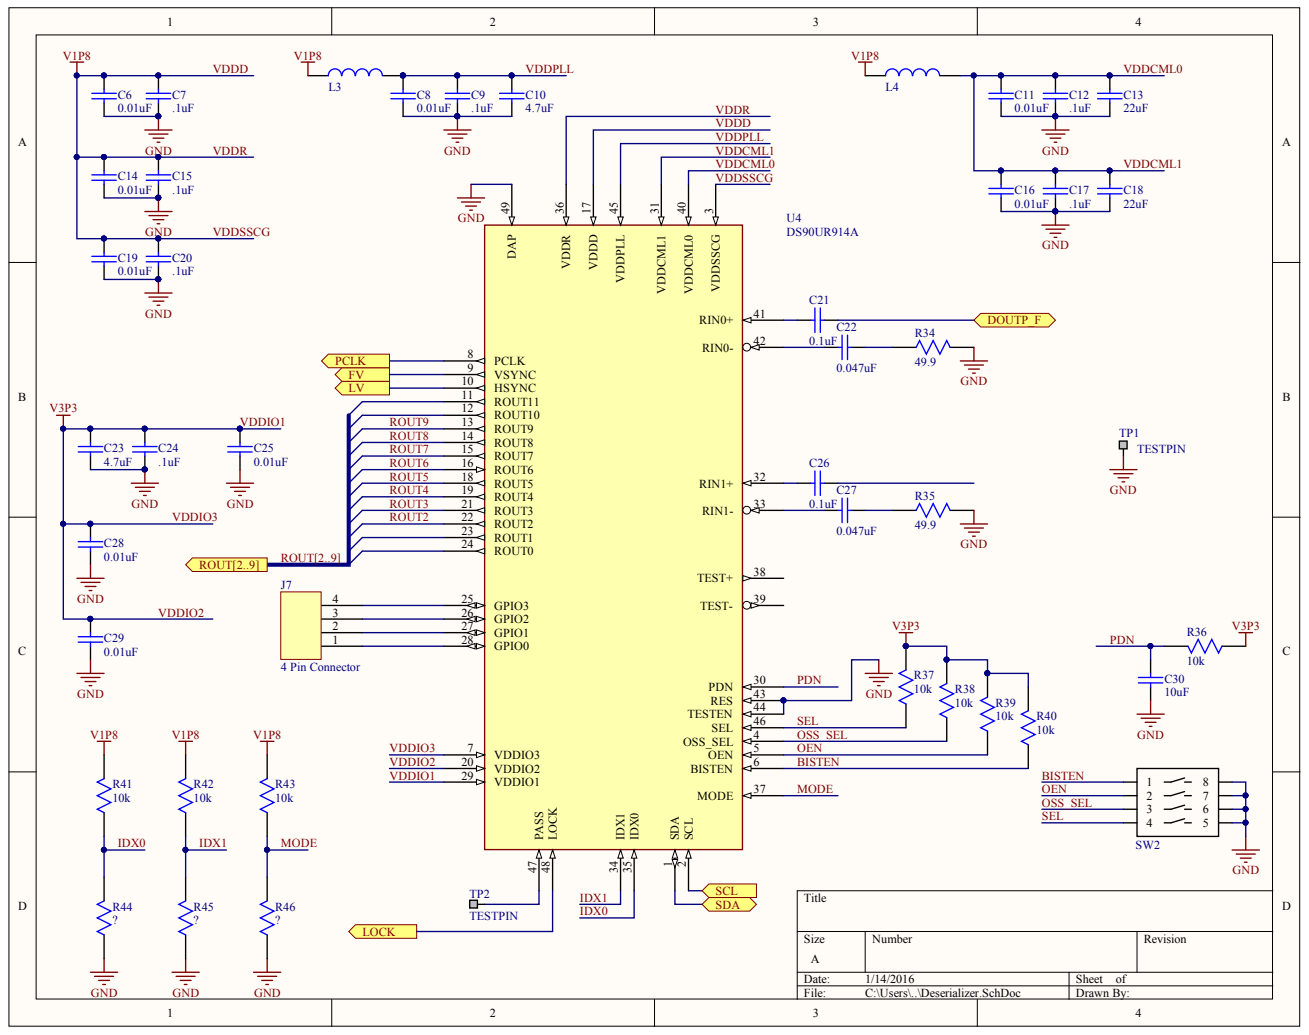
[picture p25: page 3]

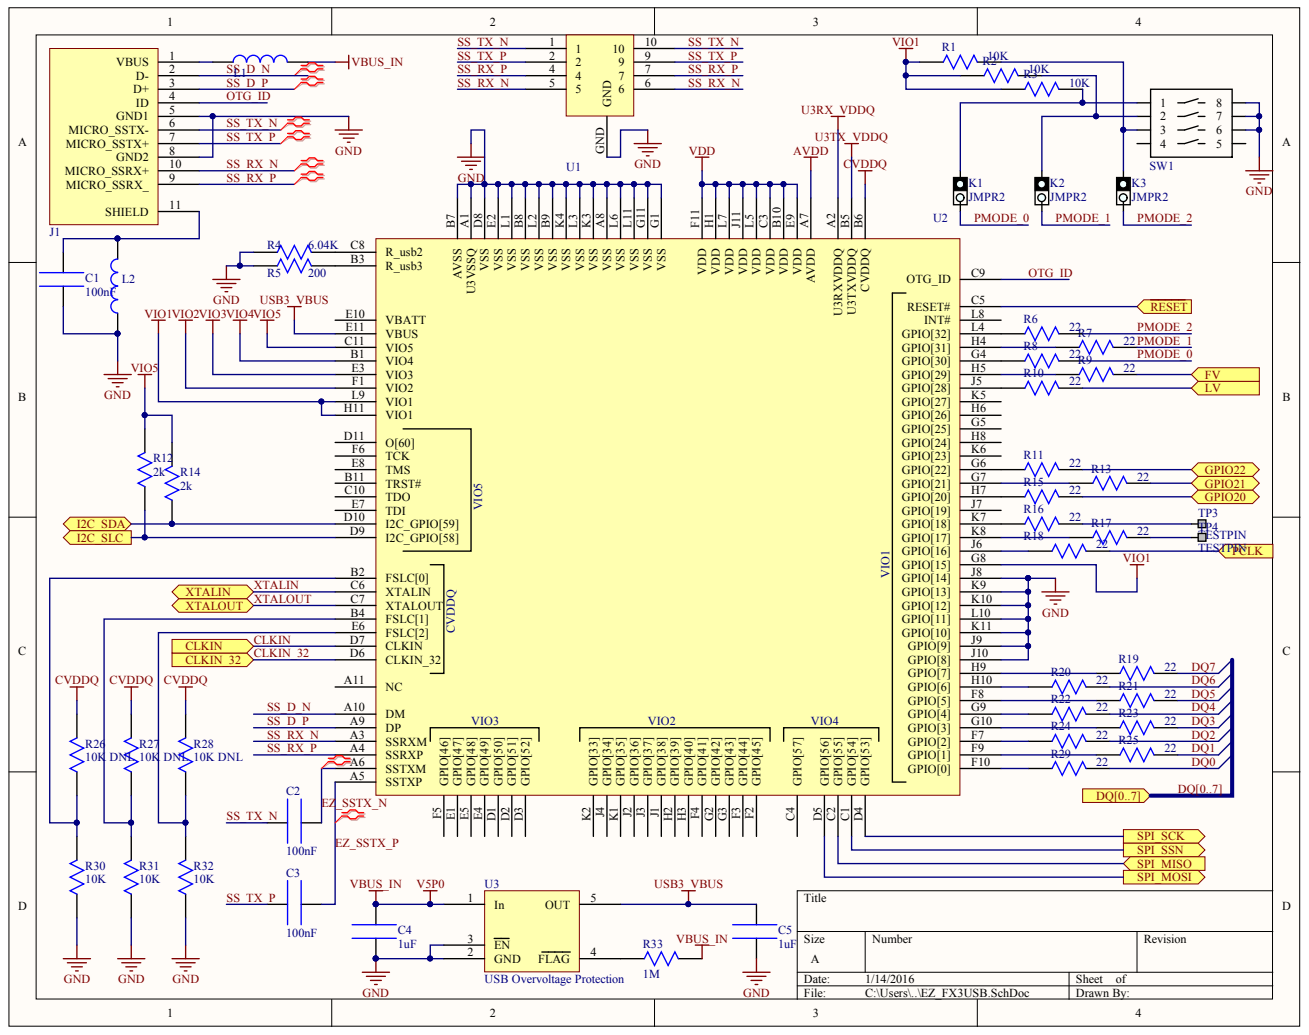
[picture p26: page 4]

VSS A8 VSS K3 VSS L3 VSS K4

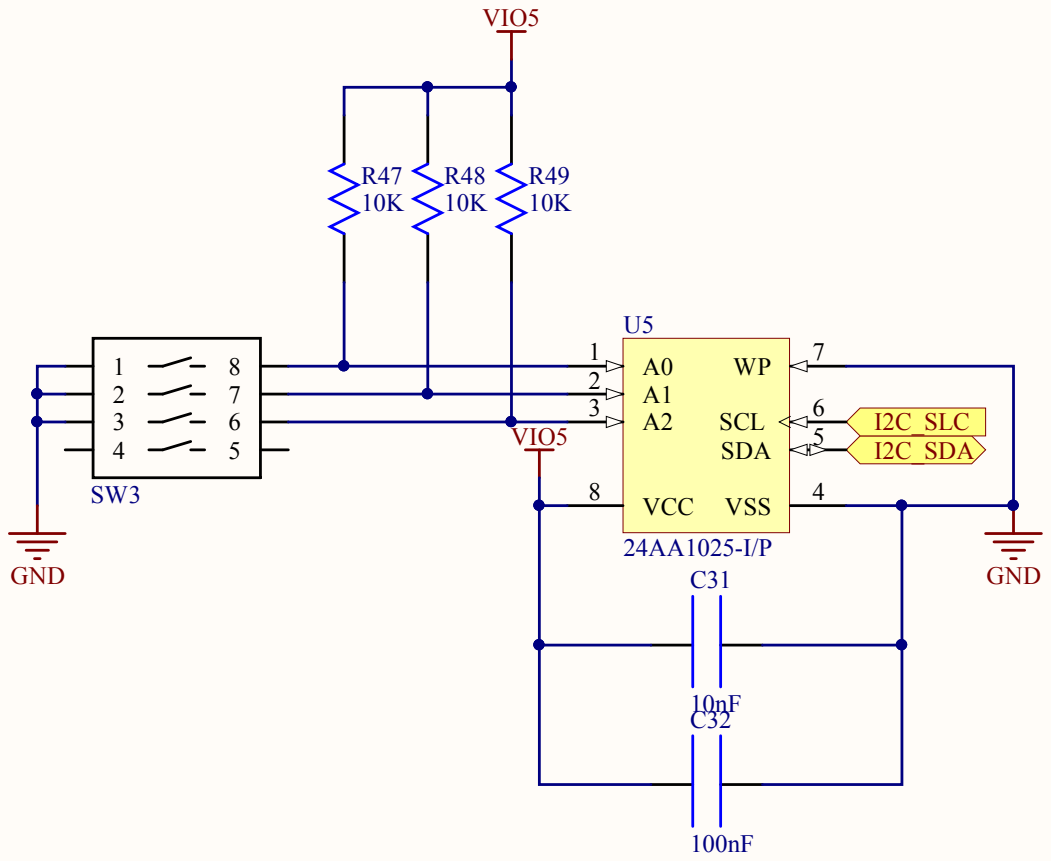
[picture p27: page 5]

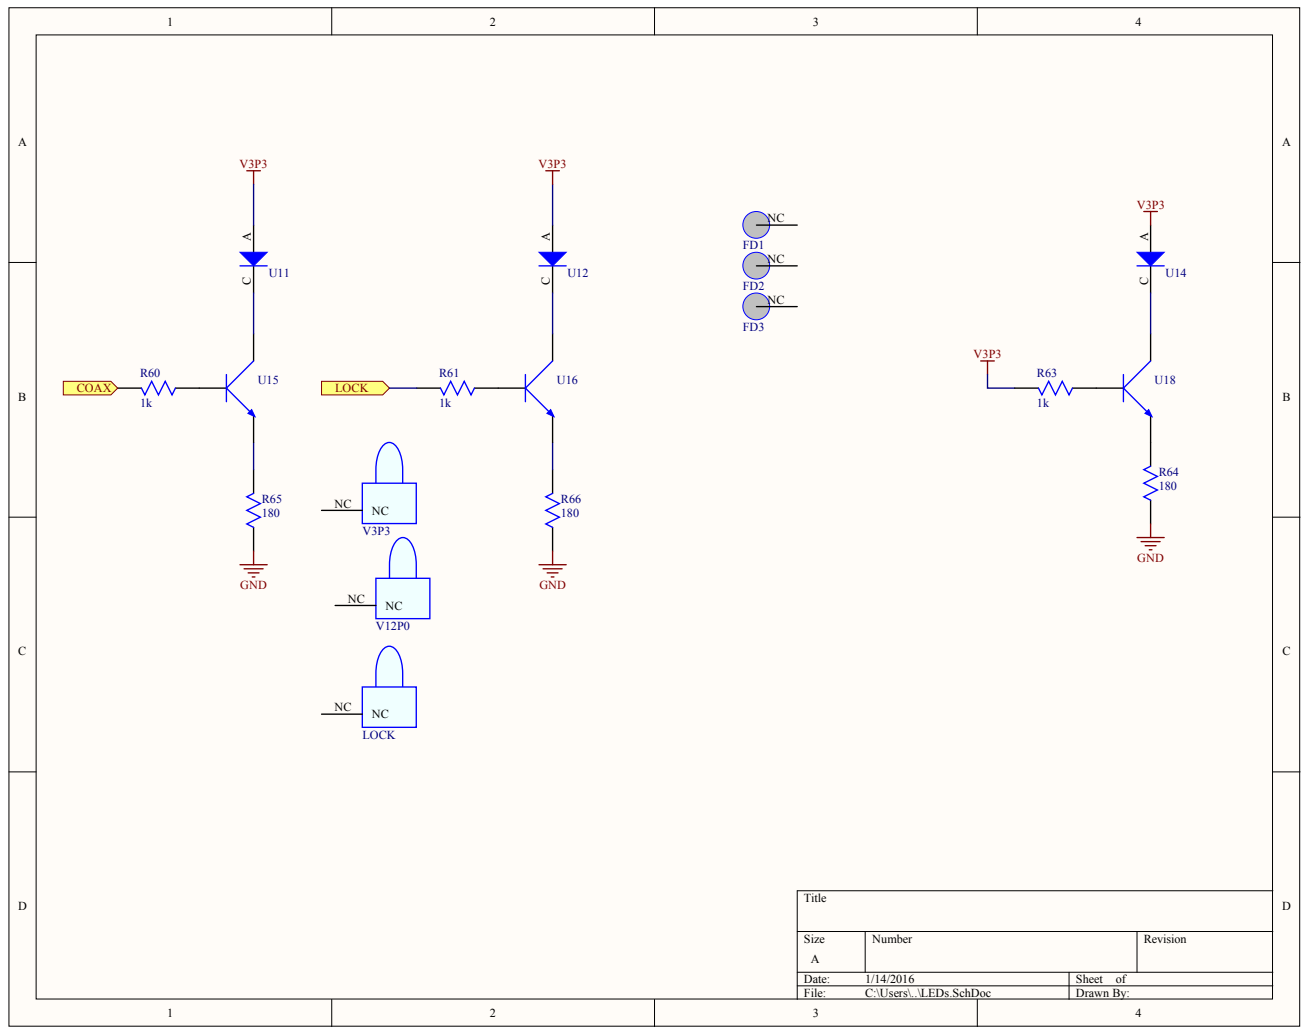
[picture p28: page 6]

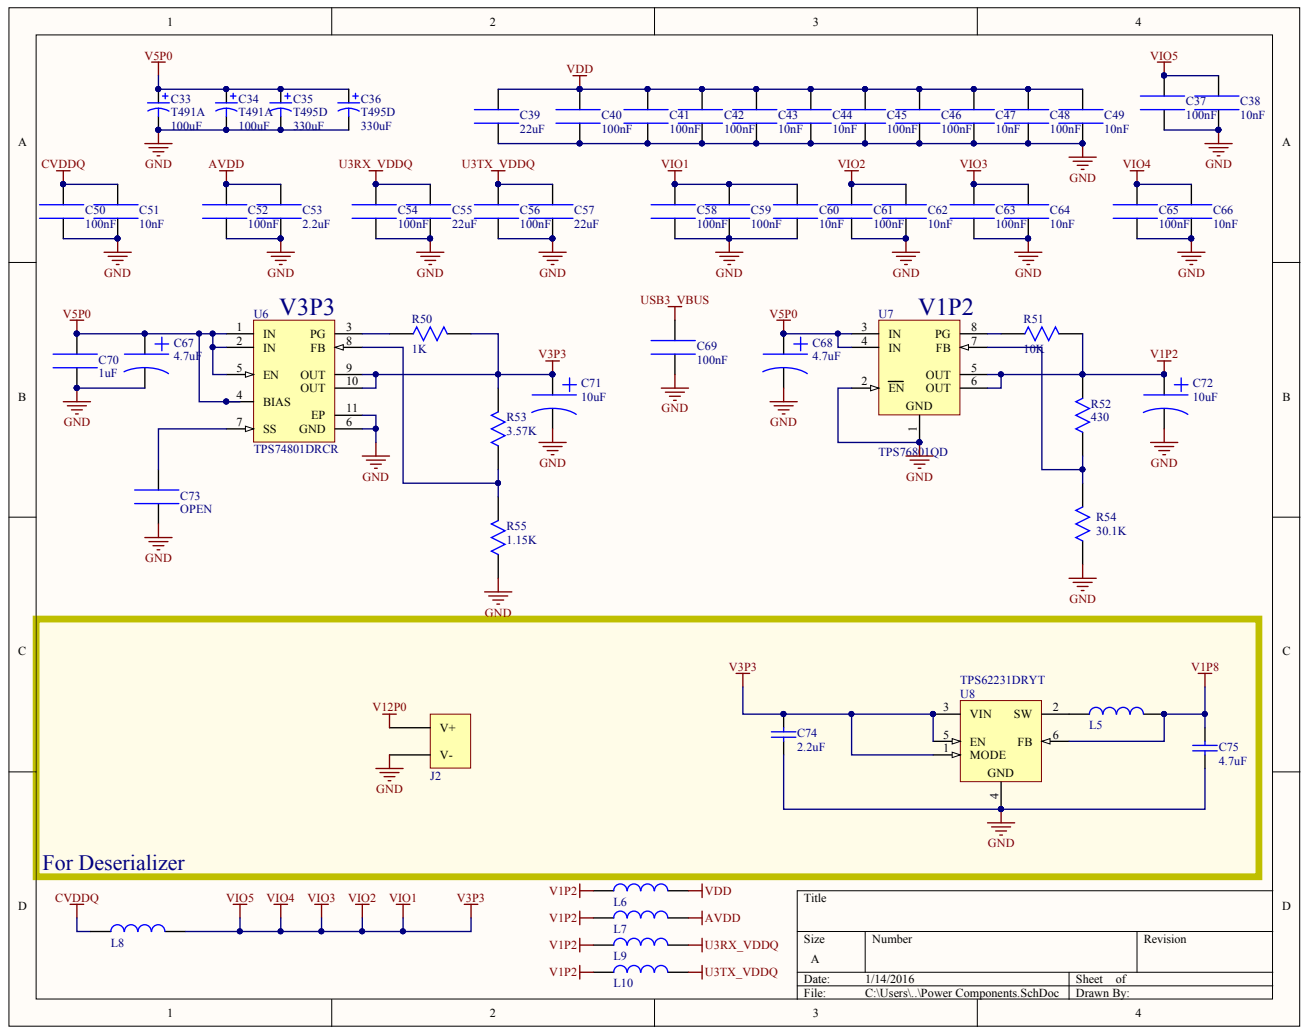
[picture p29: page 7]

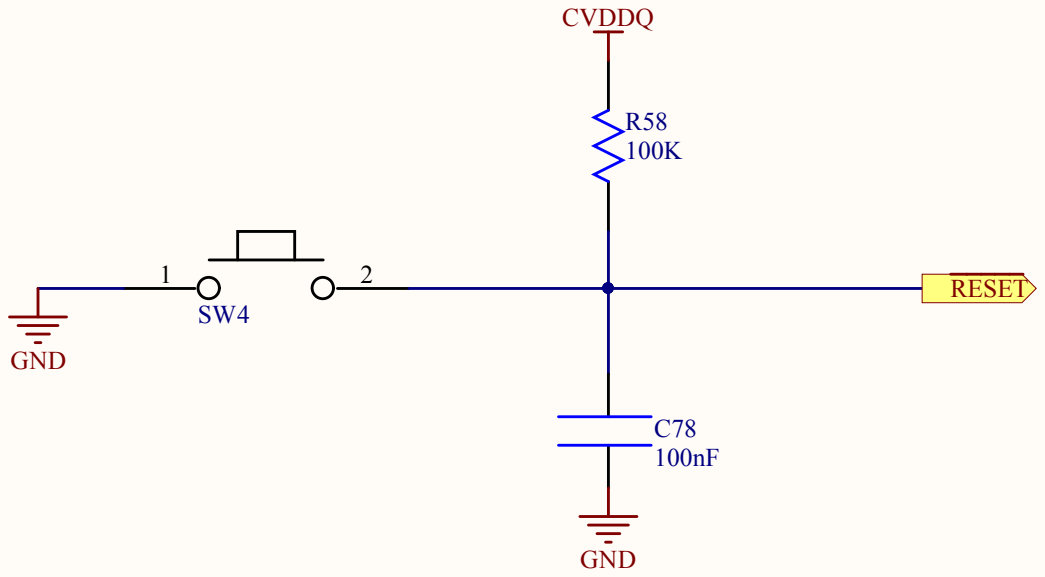
[picture p30: page 8]

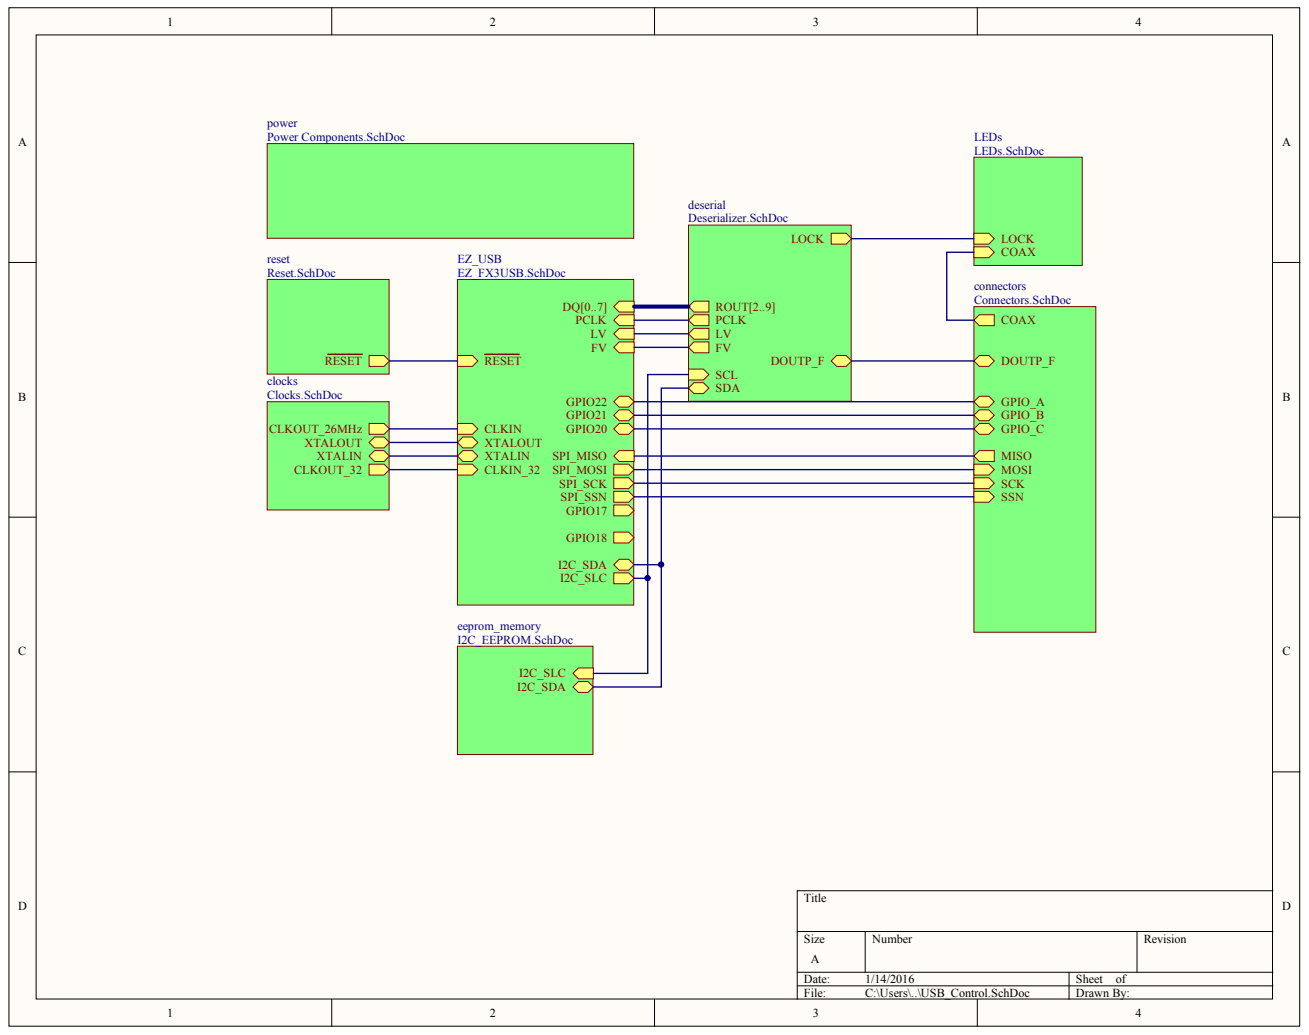
[picture p31: page 9]

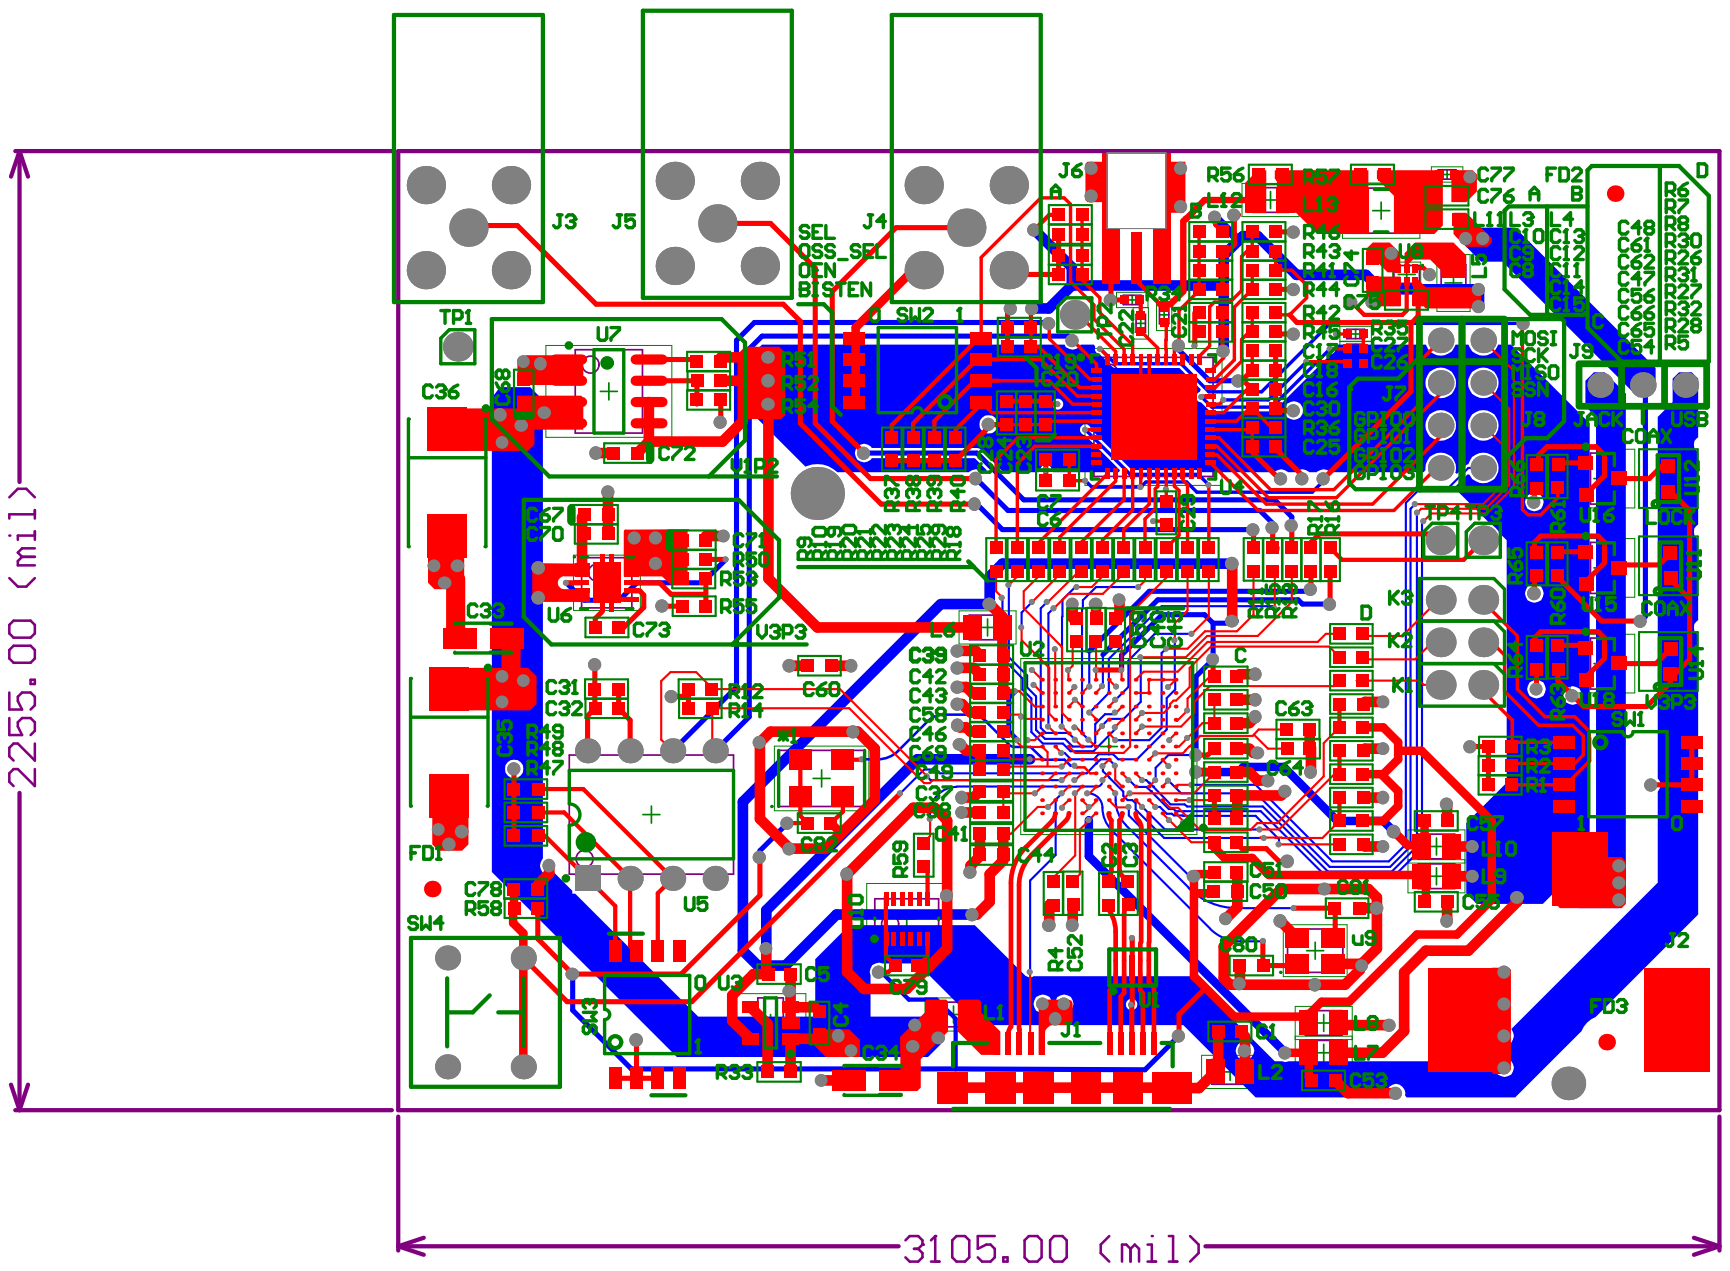
[picture p32: page 10]
