daharoni/Miniscope_DAQ_PCB/(list of files, drawings)

Other design files:
v3_2/Design Files/Clocks.SchDoc
v3_2/Design Files/Connectors.SchDoc
v3_2/Design Files/Deserializer.SchDoc
v3_2/Design Files/Dual_DAC_ConstCurrentSource.SchDoc
v3_2/Design Files/EZ_FX3USB.SchDoc
v3_2/Design Files/I2C_EEPROM.SchDoc
v3_2/Design Files/LEDs.SchDoc
v3_2/Design Files/Miniscope_USB_Control.PrjPcb
v3_2/Design Files/Power Components.SchDoc
v3_2/Design Files/Reset.SchDoc
v3_2/Design Files/USB_Control.PcbDoc
v3_2/Design Files/USB_Control.SchDoc
v3_2/Design Files/Voltage Components.SchDoc
