daharoni/Miniscope_DAQ_PCB/(commit log)

2016-01-08 Initial Uploade
    [Clocks.SchDoc, Connectors.SchDoc, Deserializer.SchDoc, Dual_DAC_ConstCurrentSource.SchDoc, EZ_FX3USB.SchDoc, I2C_EEPROM.SchDoc, LEDs.SchDoc, Miniscope_USB_Control.PrjPcb]
2016-01-08 BOM Correction
    [Pick Place for USB_Control.csv, USB_Control_FPD_Linkv2_BOM.xlsx]
2016-01-14 Switched Folder Name
    [Pick Place for USB_Control.csv, USB_Control_FPD_Linkv2_BOM.xlsx]
2016-01-15 PDF of DAQ PCB Project
2016-01-20 Updated LED Orientation Figure
2016-10-28 Added DAQ PCBv3_2
    [Clocks.SchDoc, Connectors.SchDoc, Deserializer.SchDoc, Dual_DAC_ConstCurrentSource.SchDoc, EZ_FX3USB.SchDoc, I2C_EEPROM.SchDoc, LEDs.SchDoc, Miniscope_USB_Control.PrjPcb]
2016-10-28 Added design files
    [Clocks.SchDoc, Connectors.SchDoc, Deserializer.SchDoc, Dual_DAC_ConstCurrentSource.SchDoc, EZ_FX3USB.SchDoc, I2C_EEPROM.SchDoc, LEDs.SchDoc, Miniscope_USB_Control.PrjPcb]
